rnplus/ESP8266-RELAYBOARD-V1/photo1.jpg

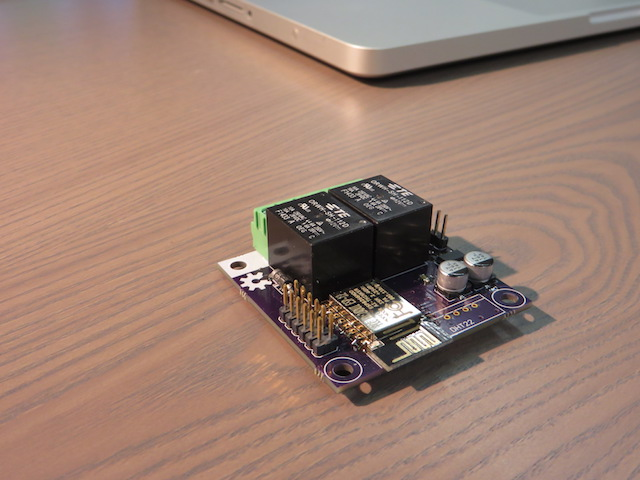
photo1.jpg
