rnplus/ESP8266-RELAYBOARD-V1/photo3.jpg

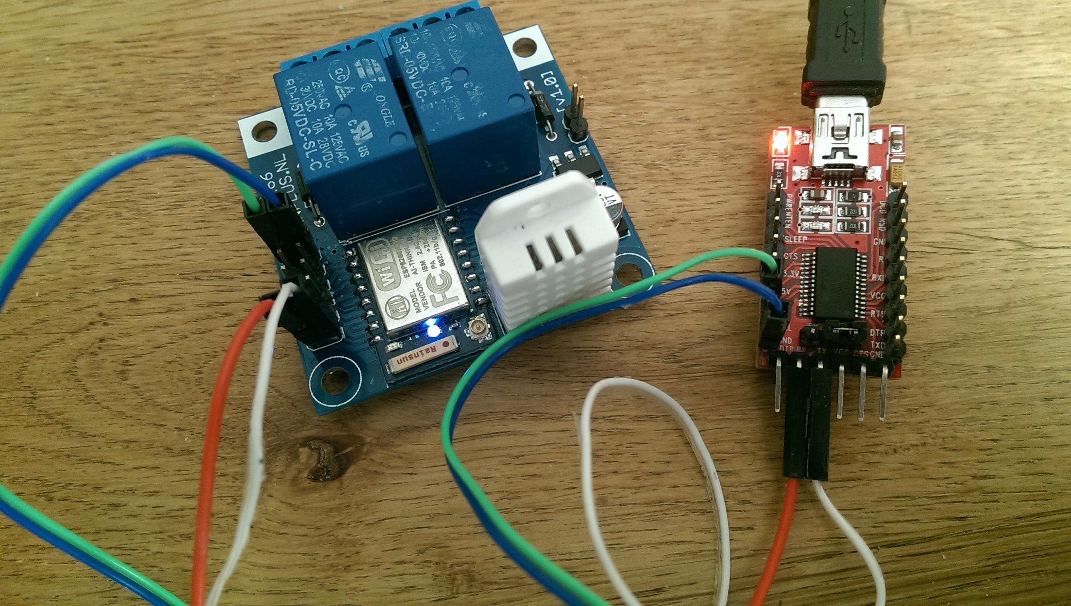
photo3.jpg
