rnplus/ESP8266-RELAYBOARD-V1/README.md

# ESP8266 relay board: hardware
In this repository you can find the eagle design files for our ESP8266 relay board.

Firmware for this board can be found here:
https://github.com/rnplus/ESP8266-relay-board-firmware

License: CC BY-SA 3.0
