rnplus/ESP8266-RELAYBOARD-V1/photo2.jpg

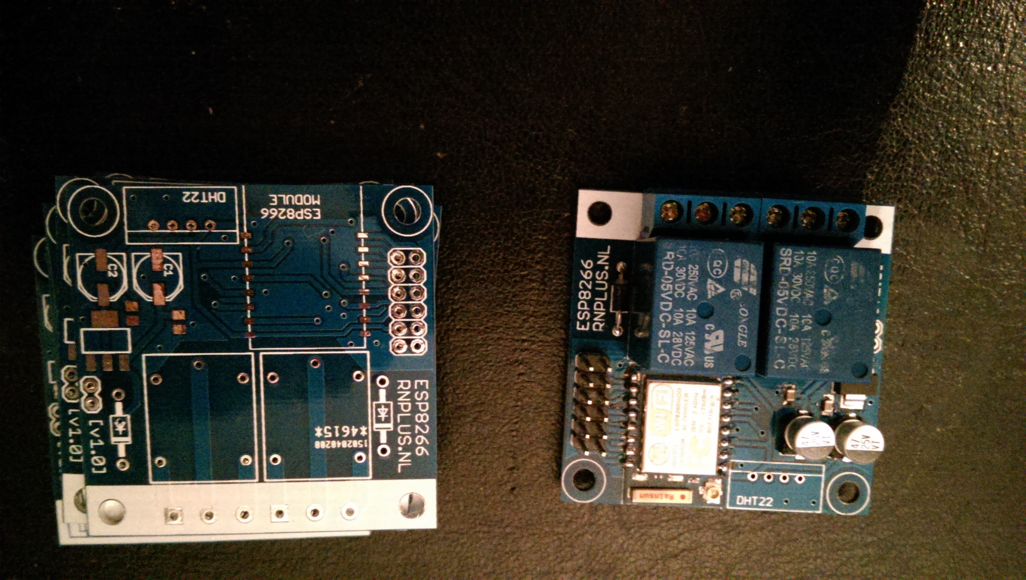
photo2.jpg
