rnplus/ESP8266-RELAYBOARD-V1/schematic.pdf

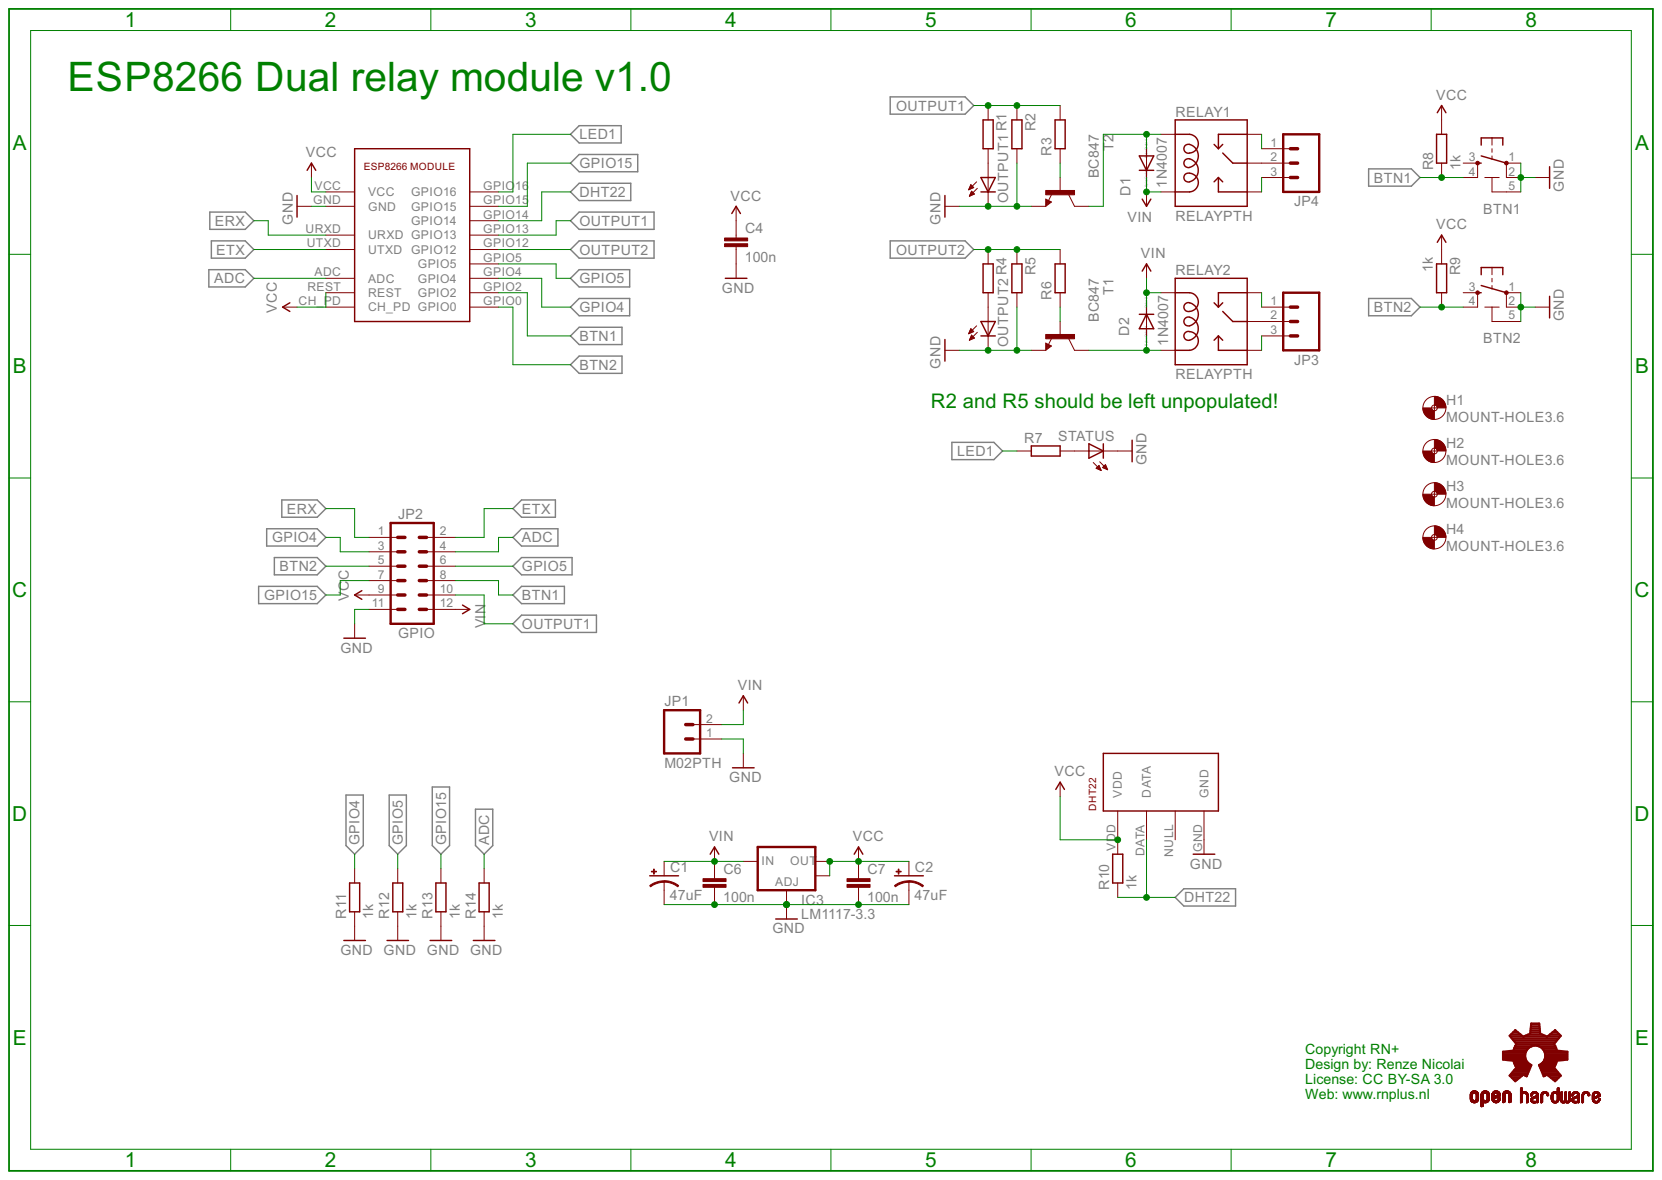
[picture p4: page 1]

SpiceOrder 1 SpiceOrder 2

R2 and R5 should be left unpopulated!

DATA DATA NULL GND GND

Copyright RN+ Design by: Renze Nicolai

License: CC BY-SA 3.0
Web: www.rnplus.nl
