rnplus/ESP8266-RELAYBOARD-V1/pcb_achterkant.pdf

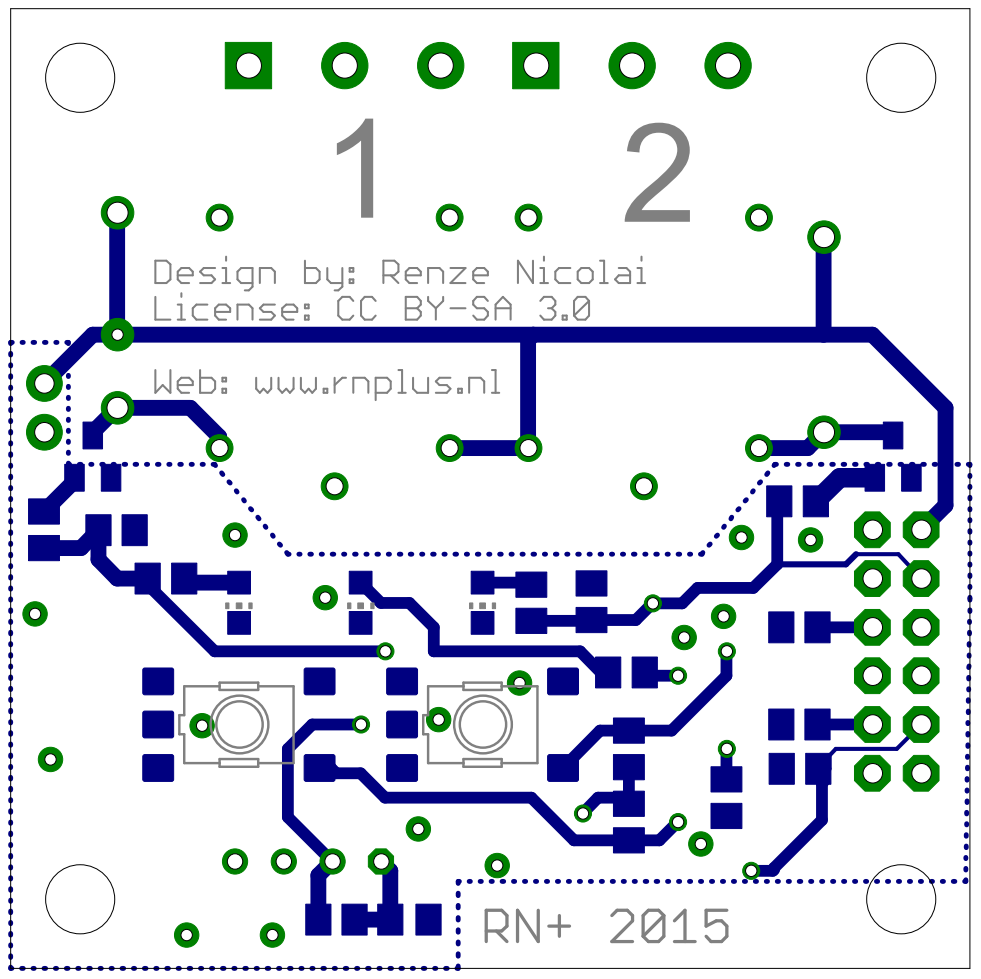
[picture p5: page 1]
