rnplus/ESP8266-RELAYBOARD-V1/pcb_achterkant_c.pdf

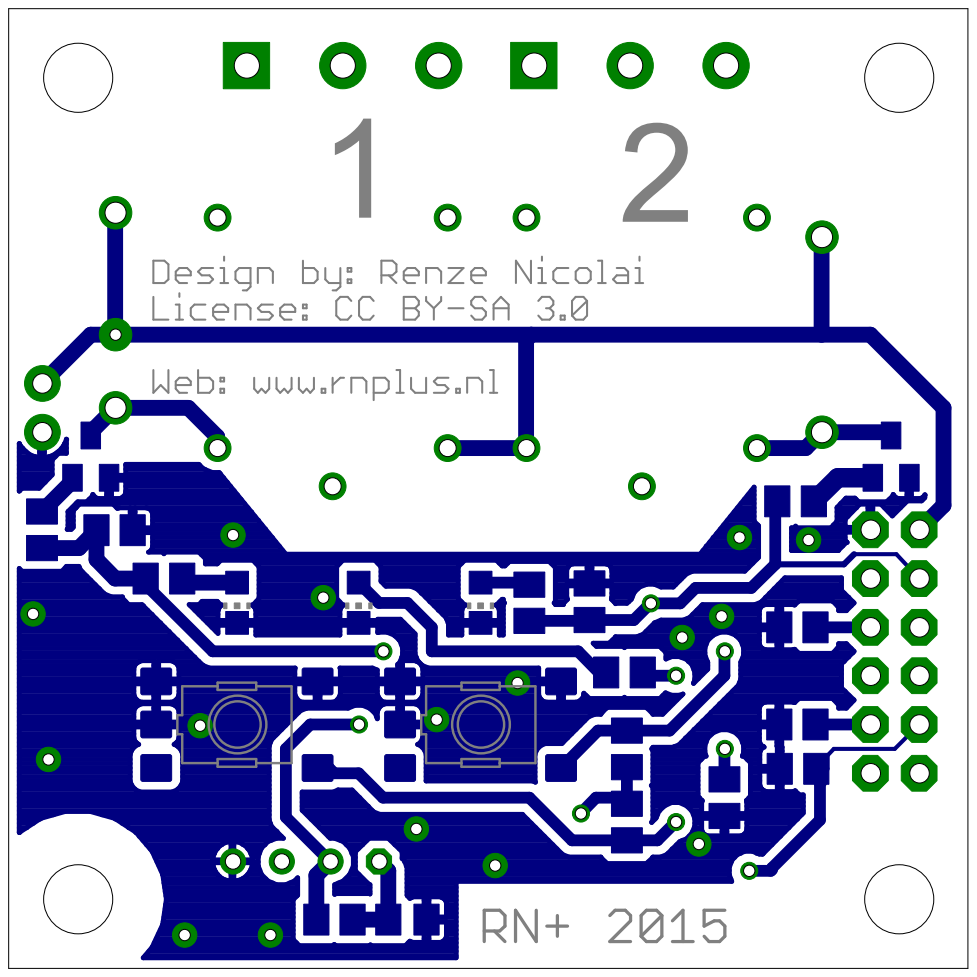
[picture p6: page 1]
