rnplus/ESP8266-RELAYBOARD-V1/pcb_voorkant.pdf

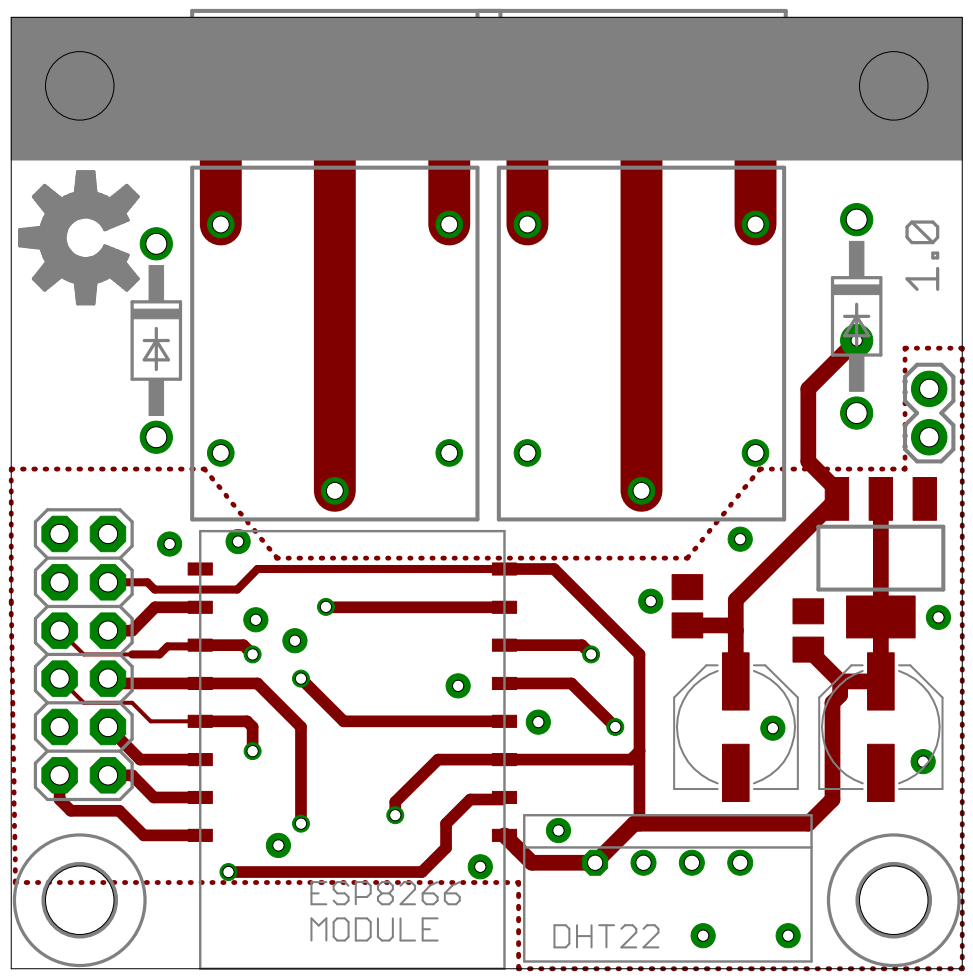
[picture p7: page 1]
