rnplus/ESP8266-RELAYBOARD-V1/pcb_voorkant_c.pdf

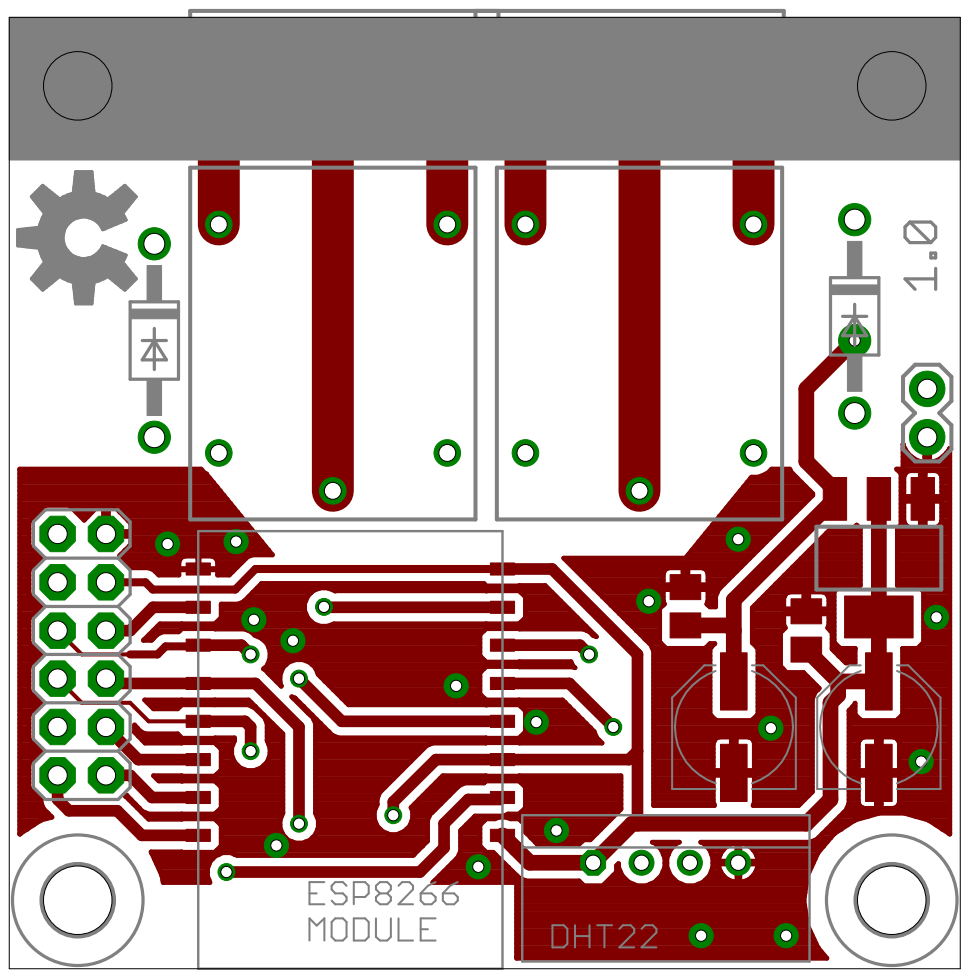
[picture p8: page 1]
