rnplus/ESP8266-RELAYBOARD-V1/eagle.brd

## EAGLE design eagle.brd (2016-03-04)

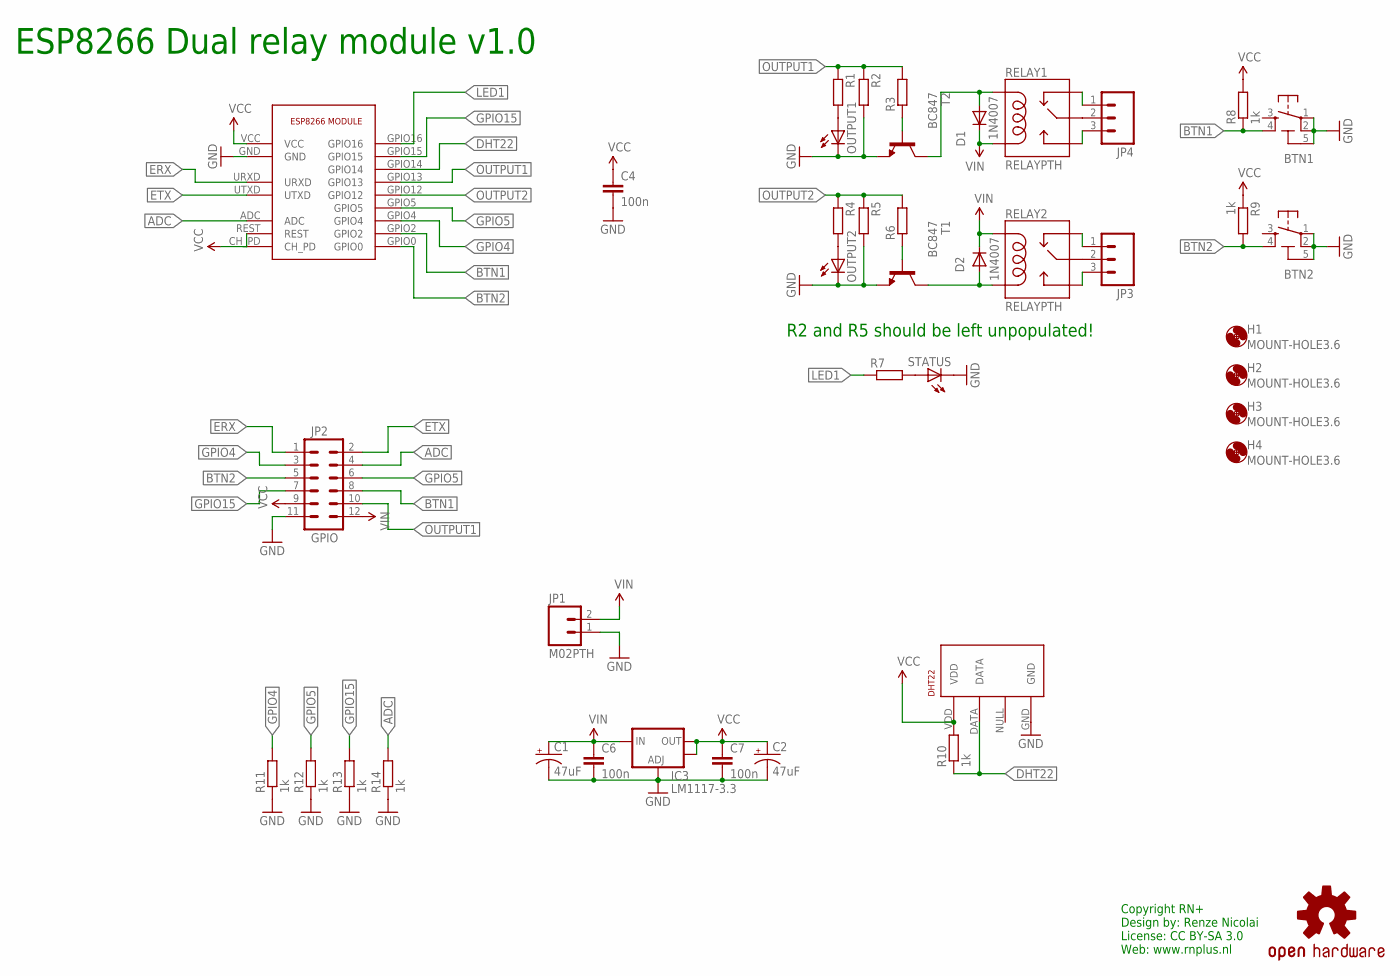
[picture p9: schematic eagle.sch]

Parts:
BTN1, BTN2: SMARTPRJ_TS42
C1, C2: 47uF; PANASONIC_D
C4, C6, C7: 100n; C0805K
D1, D2: 1N4942; DO41-10
DHT22: RHT03_DHT-22_AM2302; RHT03_DHT-22
ESP8266: ESP8266ESP-07; ESP-12
H1, H2, H3, H4: MOUNT-HOLE3.6; 3,6
IC3: LM1117-3.3; SOT223
JP1: M02PTH; 1X02
JP2: GPIO; 2X6
JP3, JP4: M03-SCREW-5MM; SCREWTERMINAL-5MM-3
LOGO1: OSHW-LOGOL; OSHW-LOGO-L
OUTPUT1, OUTPUT2: LEDCHIP-LED0805; CHIP-LED0805
R1, R2, R3, R4, R5, R6, R7: SMARTPRJ_R-EU_M0805; SMARTPRJ_M0805
R8, R9, R10, R11, R12, R13, R14: 1k; SMARTPRJ_M0805
RELAY1, RELAY2: RELAYPTH; SRD-05VDC-SL-C
STATUS: LEDCHIP-LED0805; CHIP-LED0805
T1, T2: BC847; SOT23

Connections:
ADC: ESP8266.ADC, JP2.4, R14.2
BTN1: BTN1.4, ESP8266.GPIO2, JP2.8, R8.1
BTN2: BTN2.4, ESP8266.GPIO0, JP2.5, R9.2
DHT22: DHT22.DATA, ESP8266.GPIO14, R10.1
ERX: ESP8266.URXD, JP2.1
ETX: ESP8266.UTXD, JP2.2
GND: BTN1.1, BTN1.2, BTN1.5 (5-GND), BTN2.1, BTN2.2, BTN2.5 (5-GND), C1.-, C2.-, C4.2, C6.2, C7.2, DHT22.GND, ESP8266.GND, IC3.1 (ADJ), JP1.1, JP2.11, OUTPUT1.C, OUTPUT2.C, R2.2, R5.2, R11.1, R12.1, R13.1, R14.1, STATUS.C, T1.2 (E), T2.2 (E)
GPIO4: ESP8266.GPIO4, JP2.3, R11.2
GPIO5: ESP8266.GPIO5, JP2.6, R12.2
GPIO15: ESP8266.GPIO15, JP2.7, R13.2
LED1: ESP8266.GPIO16, R7.1
unnamed: D2.A, RELAY2.COIL0, T1.3 (C)
unnamed: D1.A, RELAY1.COIL1, T2.3 (C)
unnamed: JP3.2, RELAY2.SWCOMMON
unnamed: JP4.2, RELAY1.SWCOMMON
unnamed: JP4.1, RELAY1.SWCLOSED (SWCLOSE)
unnamed: JP4.3, RELAY1.SWOPEN
unnamed: JP3.3, RELAY2.SWOPEN
unnamed: JP3.1, RELAY2.SWCLOSED (SWCLOSE)
unnamed: R3.1, T2.1 (B)
unnamed: R6.1, T1.1 (B)
unnamed: OUTPUT2.A, R4.2
unnamed: R7.2, STATUS.A
unnamed: OUTPUT1.A, R1.2
OUTPUT1: ESP8266.GPIO13, JP2.10, R1.1, R2.1, R3.2
OUTPUT2: ESP8266.GPIO12, R4.1, R5.1, R6.2
VCC: C2.+, C4.1, C7.1, DHT22.VDD, ESP8266.CH_PD, ESP8266.REST, ESP8266.VCC, IC3.2 (OUT), IC3.4 (OUT), JP2.9, R8.2, R9.1, R10.2
VIN: C1.+, C6.1, D1.C, D2.C, IC3.3 (IN), JP1.2, JP2.12, RELAY1.COIL0, RELAY2.COIL1

Notes on the sheet:
Copyright RN+ Design by: Renze Nicolai License: CC BY-SA 3.0 Web: www.rnplus.nl
ESP8266 Dual relay module v1.0
1N4007
R2 and R5 should be left unpopulated!

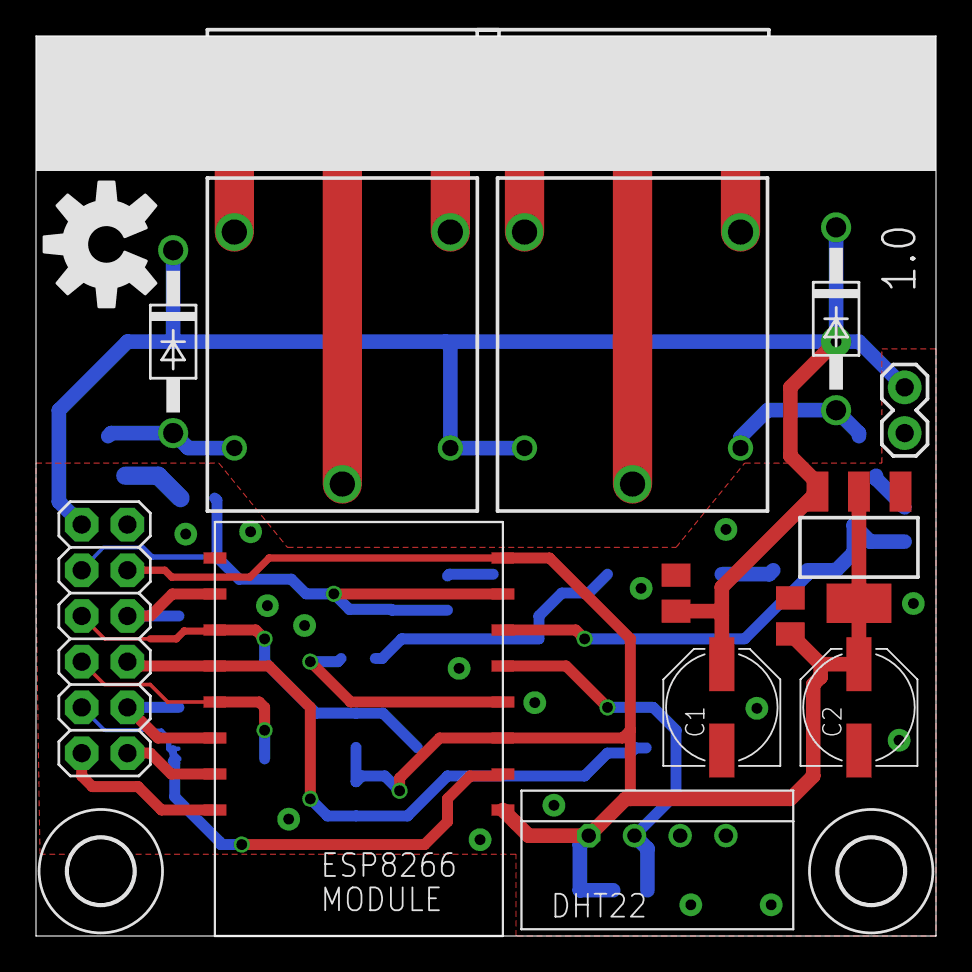
[picture p10: board eagle.brd from above]

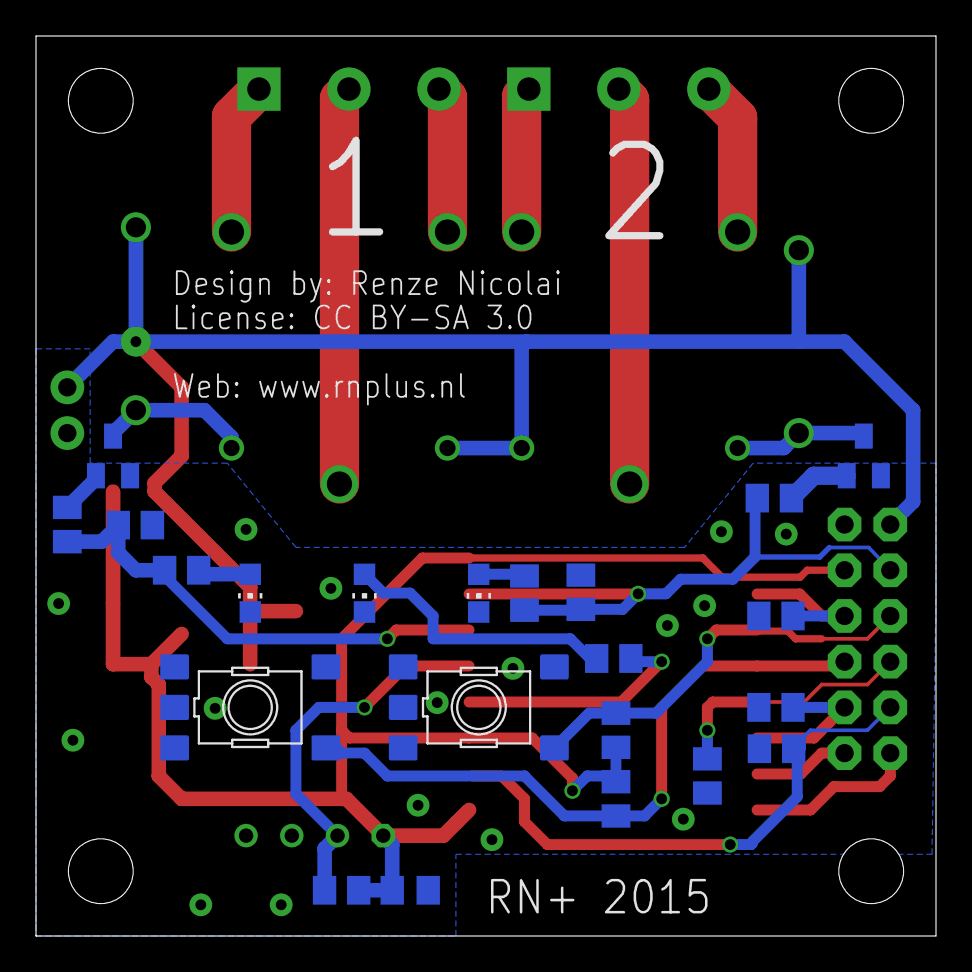
[picture p11: board eagle.brd from below]

Board: 2 copper layers, 50.0 x 50.0 mm, 42 parts (22 on the bottom side), 28 nets.
