rnplus/ESP8266-RELAYBOARD-V1/(commit log)

2015-04-16 Initial version
    [eagle.brd, eagle.sch]
2016-03-04 Increased drill size for relays
    [eagle.brd]
2016-03-04 Increased drill size for relays to 1.4mm
    [eagle.brd]
2016-03-04 Add BOM
    [bom.csv]
2016-03-04 use commas as seperator
    [bom.csv]
2016-03-04 Added extra bom with links to chinese sellers, added extra photo
2016-03-04 Added extra bom and extra photo
    [bom_china.csv]
